johaas-ams/FilaLoom/Media/cable_driven_examples.jpg

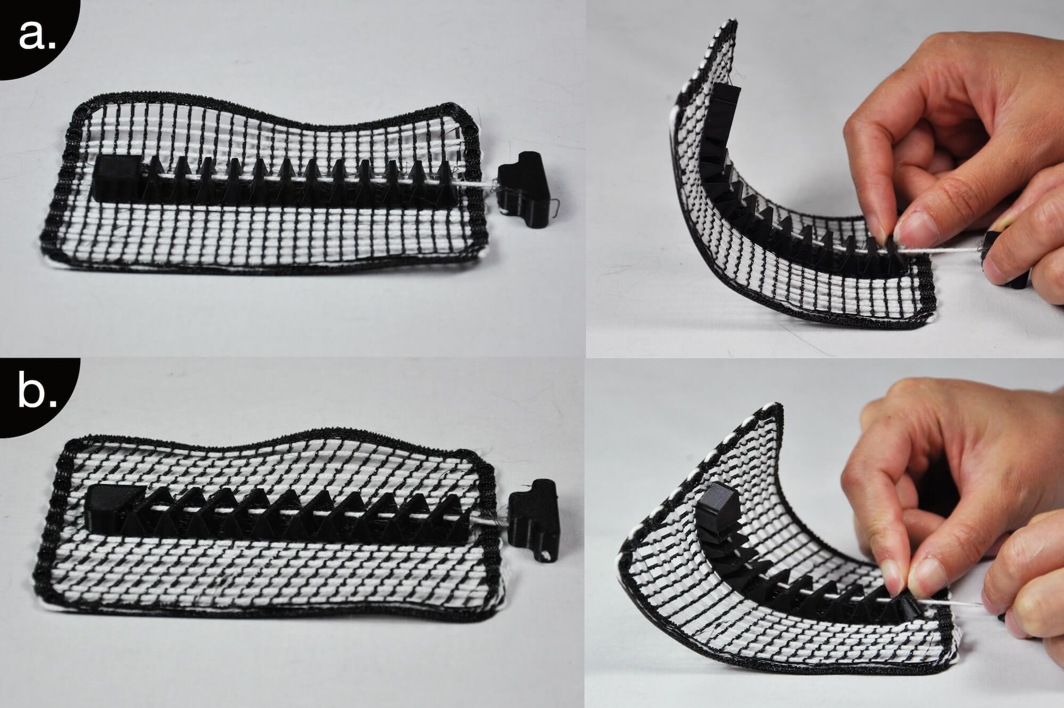
Media/cable_driven_examples.jpg
