johaas-ams/FilaLoom/Media/cable_driven_story_final.jpg

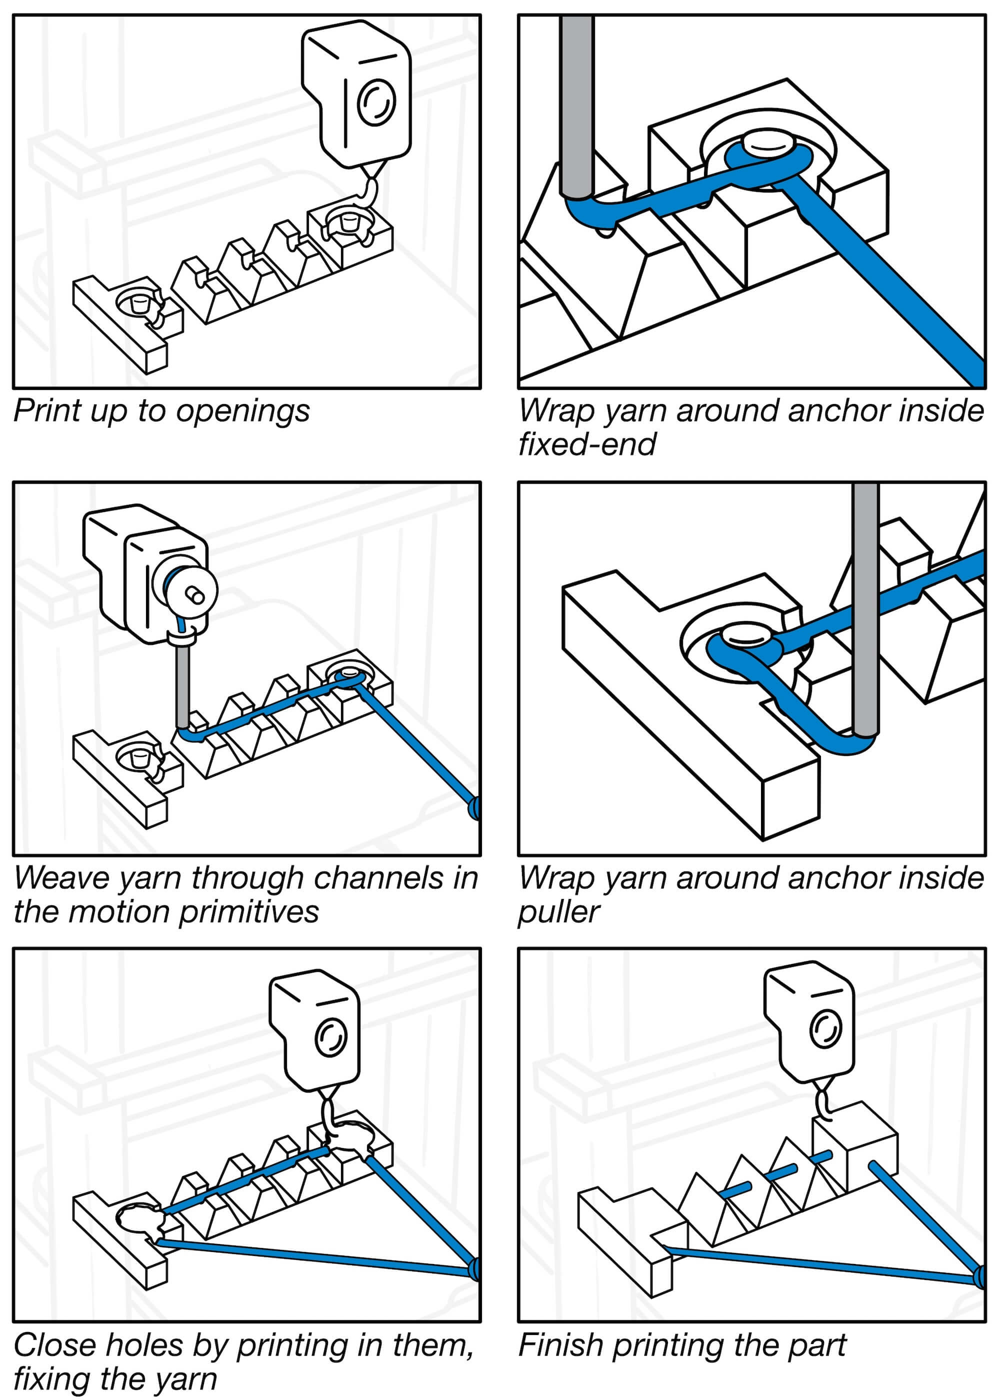
Media/cable_driven_story_final.jpg
