johaas-ams/FilaLoom/Media/cover_final.jpg

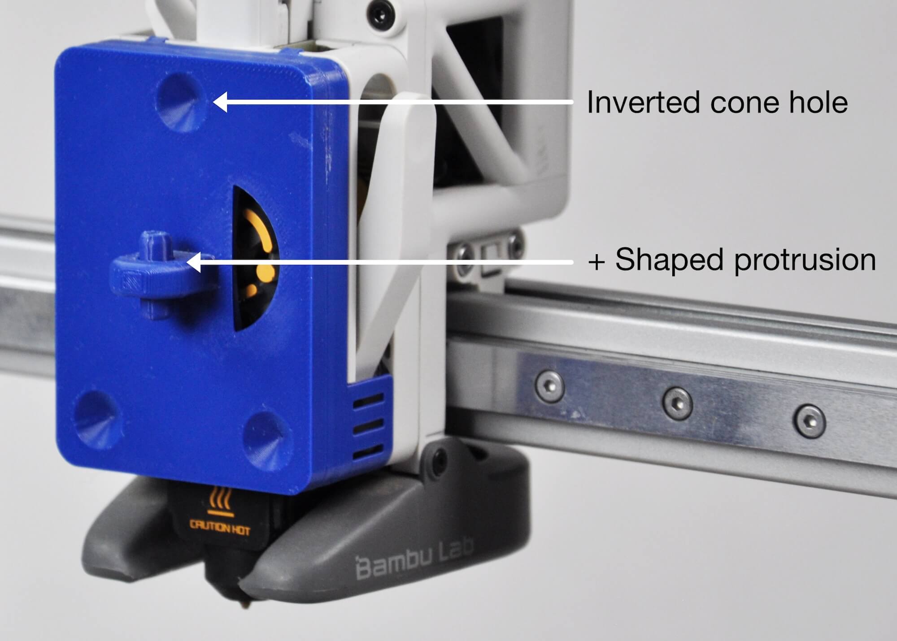
Media/cover_final.jpg
