johaas-ams/FilaLoom/Media/depositor_final.jpg

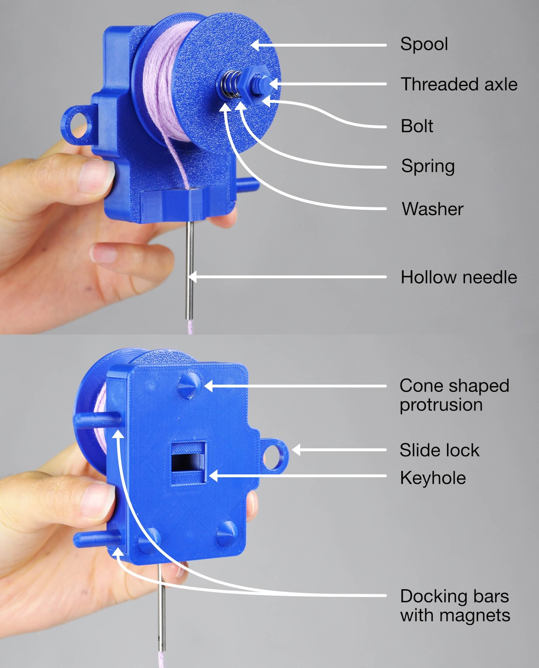
Media/depositor_final.jpg
