johaas-ams/FilaLoom/Media/double_station_final.jpg

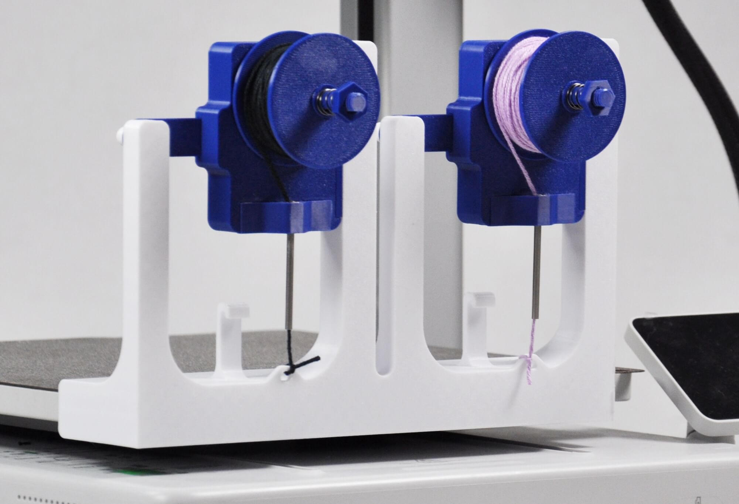
Media/double_station_final.jpg
