johaas-ams/FilaLoom/Media/fixation.jpg

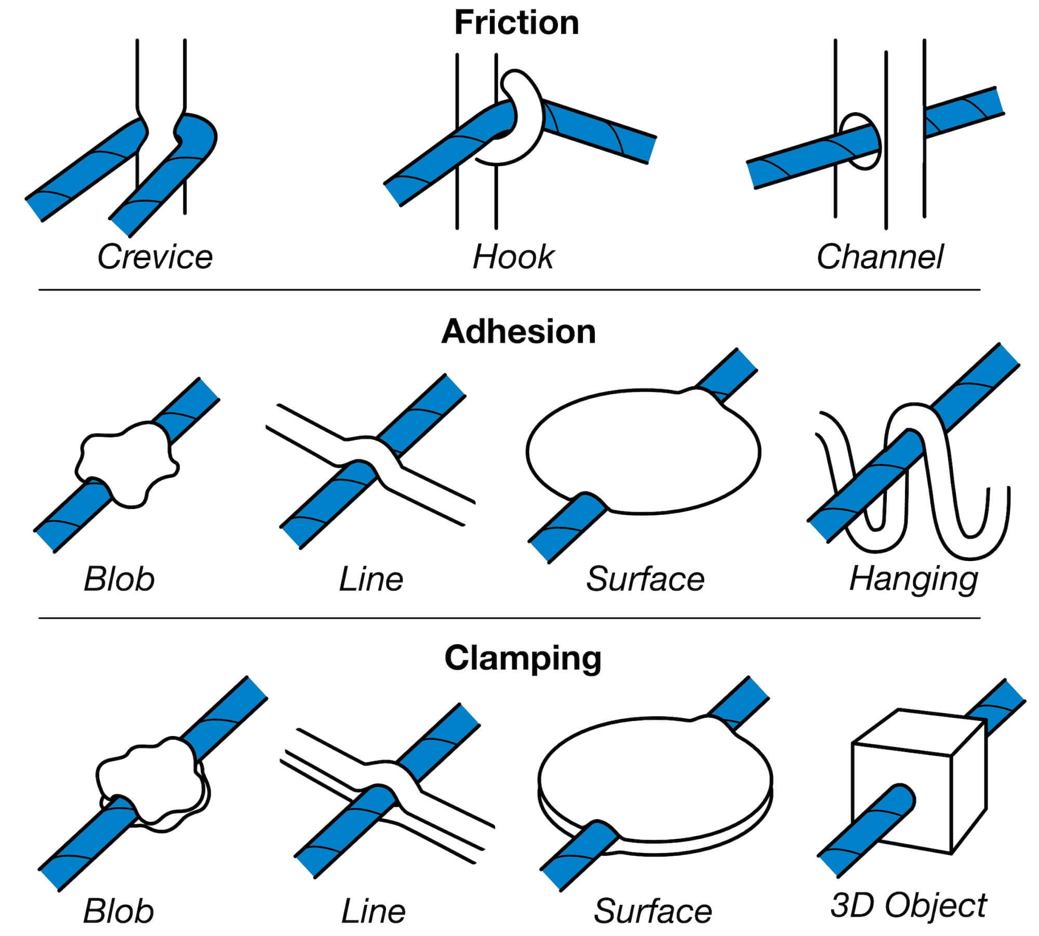
Media/fixation.jpg
