johaas-ams/FilaLoom/Media/general_story_final.jpg

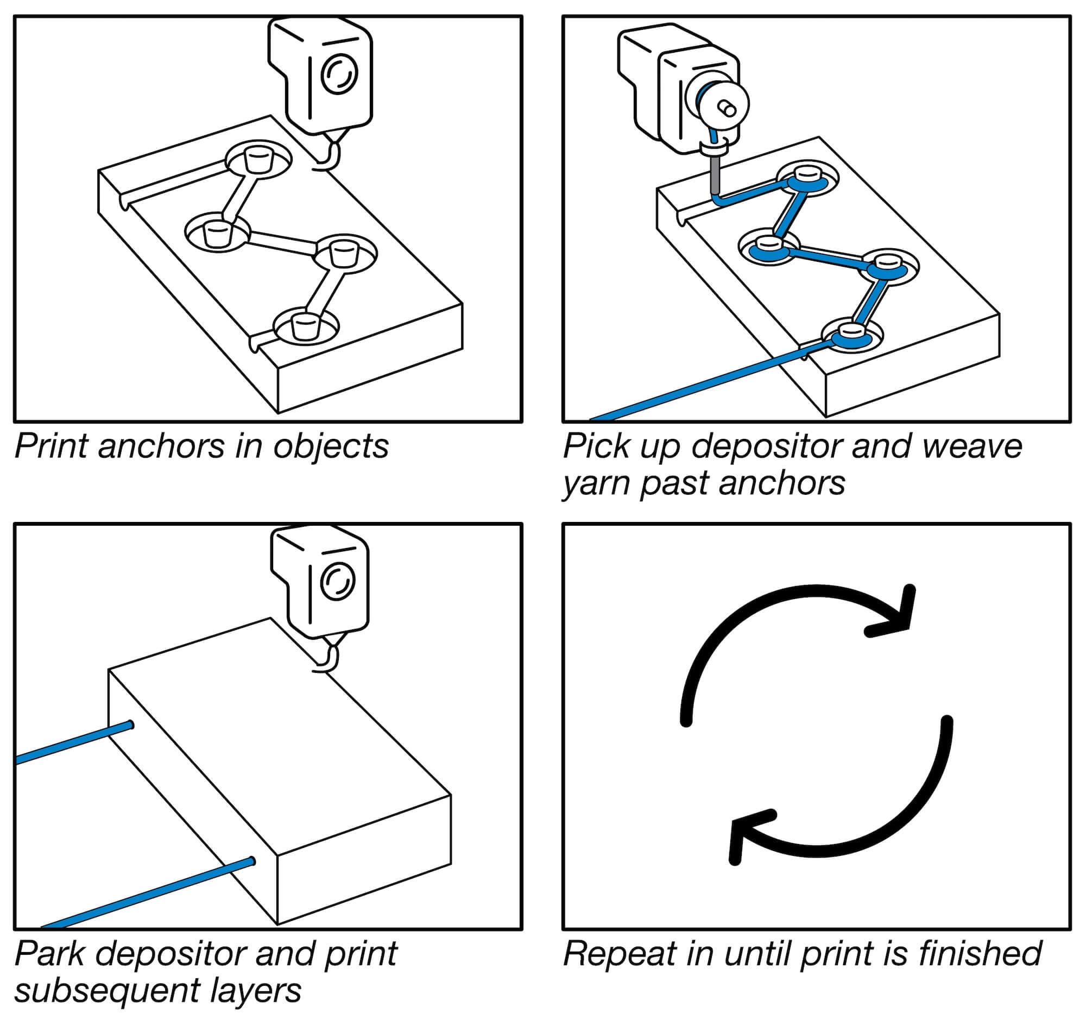
Media/general_story_final.jpg
