johaas-ams/FilaLoom/Media/loops_examples_final.jpg

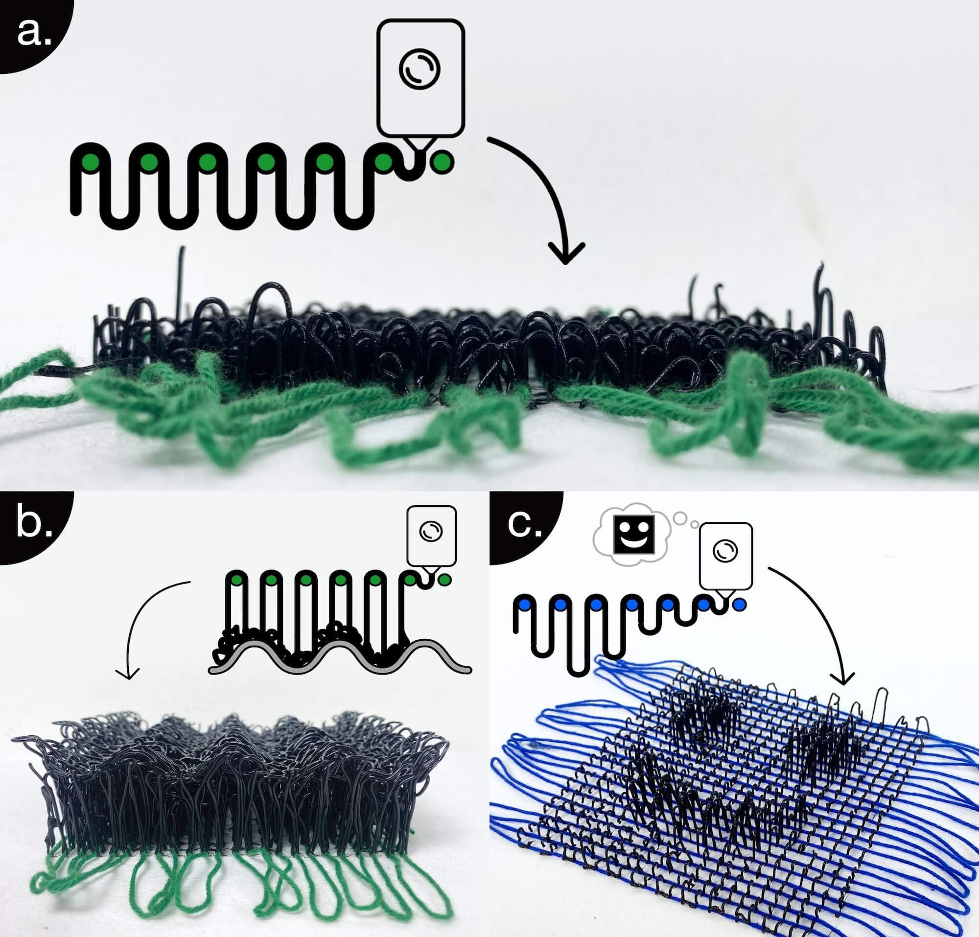
Media/loops_examples_final.jpg
