johaas-ams/FilaLoom/Media/loops_story_final.jpg

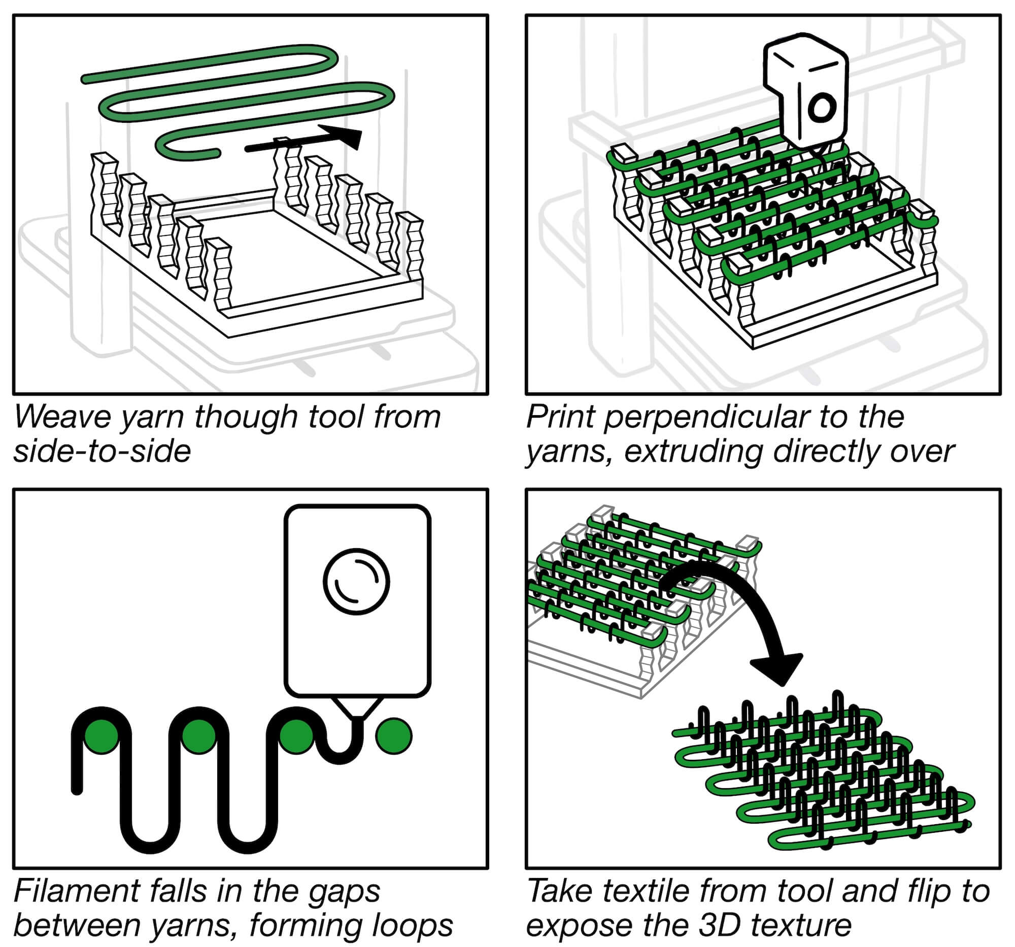
Media/loops_story_final.jpg
