johaas-ams/FilaLoom/Media/pickpark_final.jpg

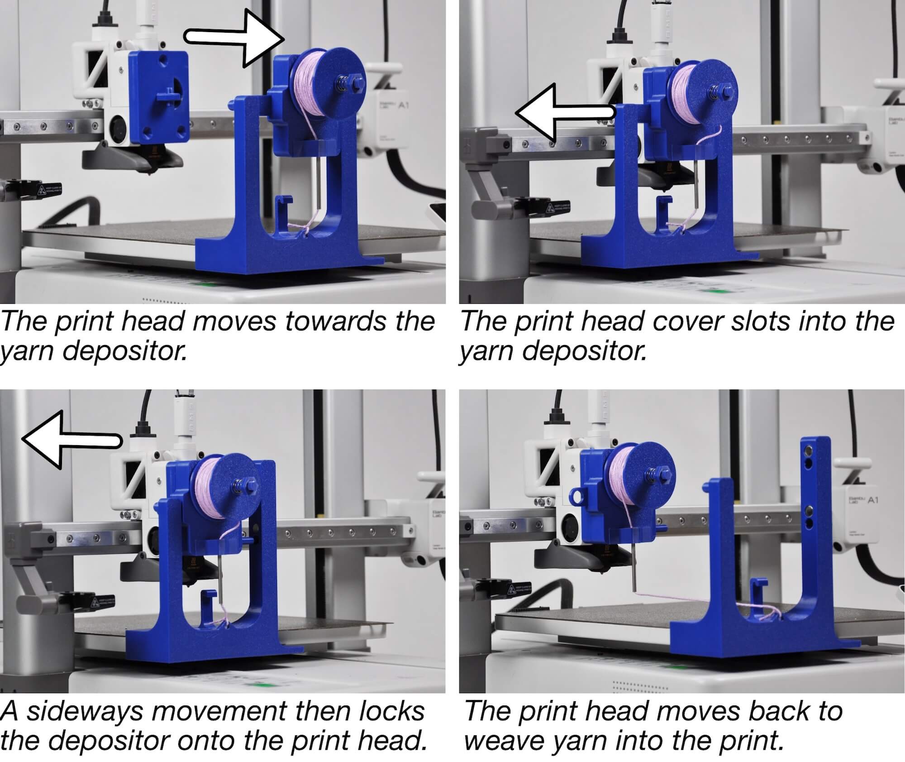
Media/pickpark_final.jpg
