johaas-ams/FilaLoom/Media/pillar_weaving_story_final.jpg

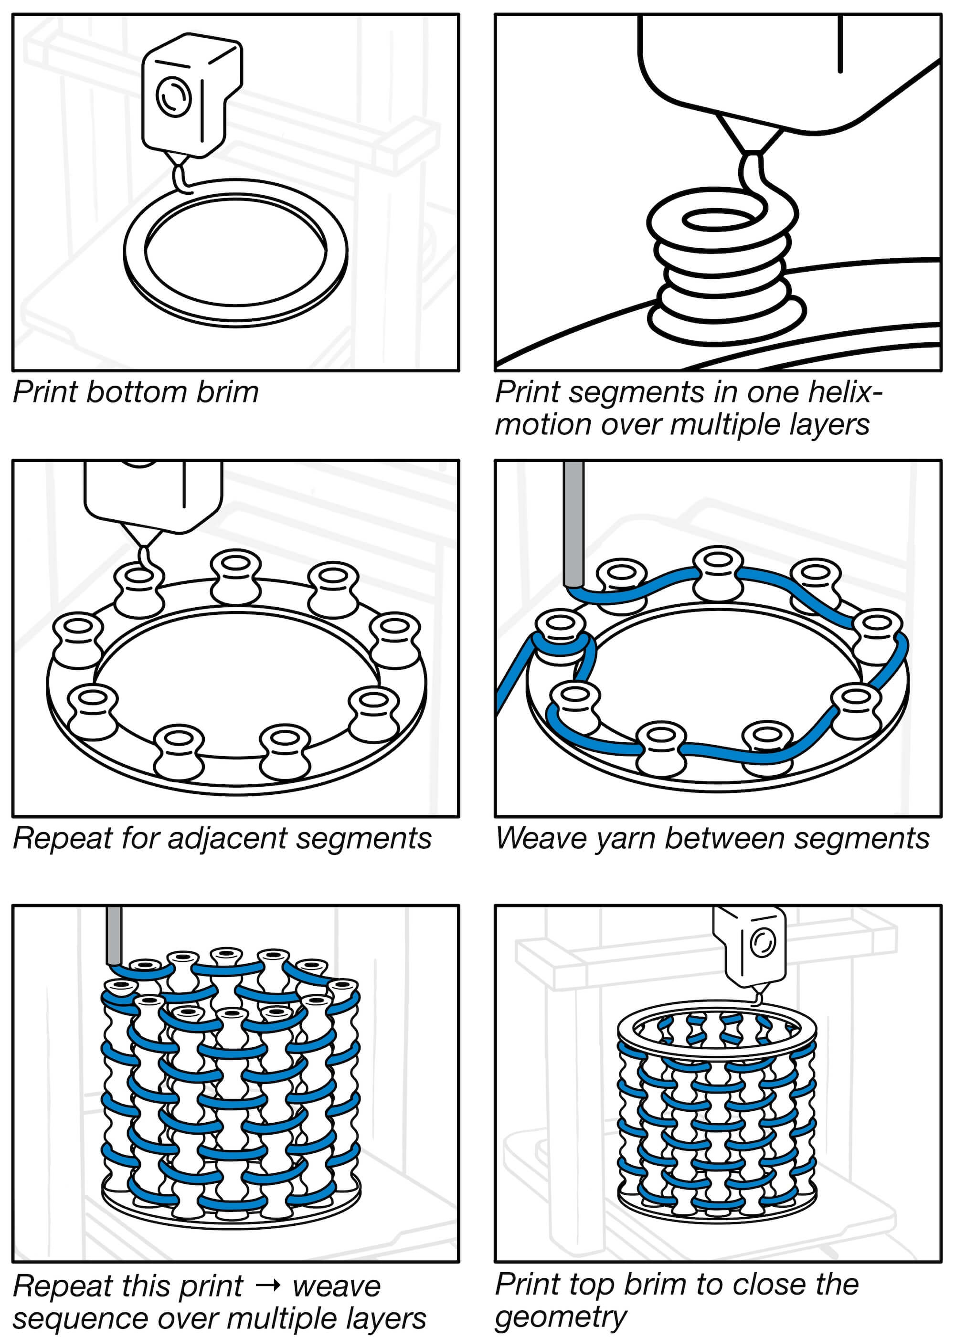
Media/pillar_weaving_story_final.jpg
