johaas-ams/FilaLoom/Media/pillar_weaving_variables.jpg

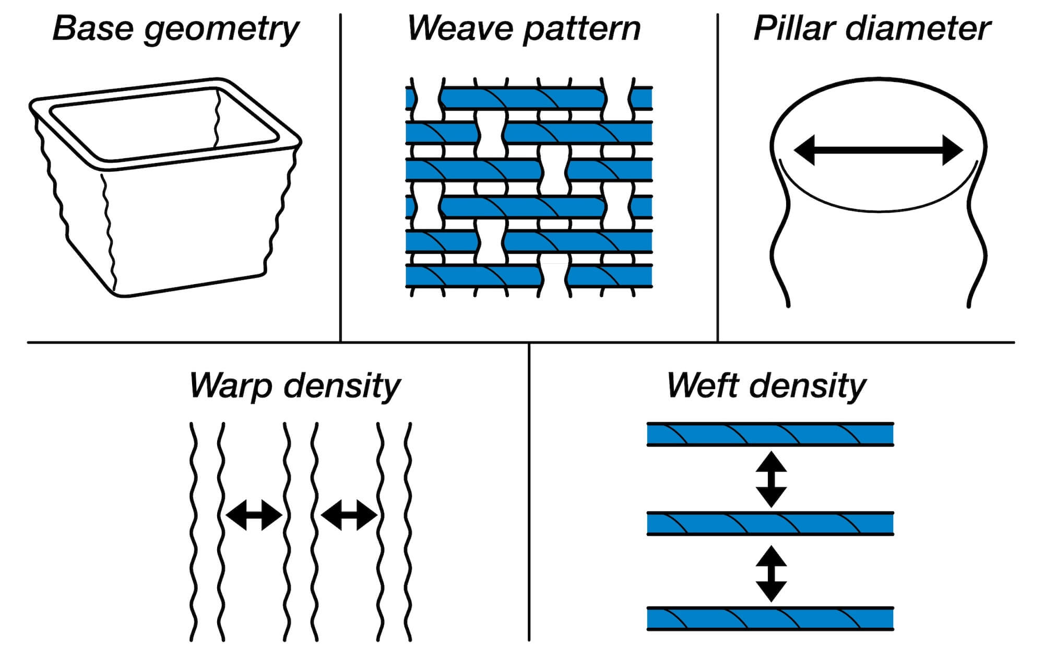
Media/pillar_weaving_variables.jpg
