johaas-ams/FilaLoom/Media/planar_examples.jpg

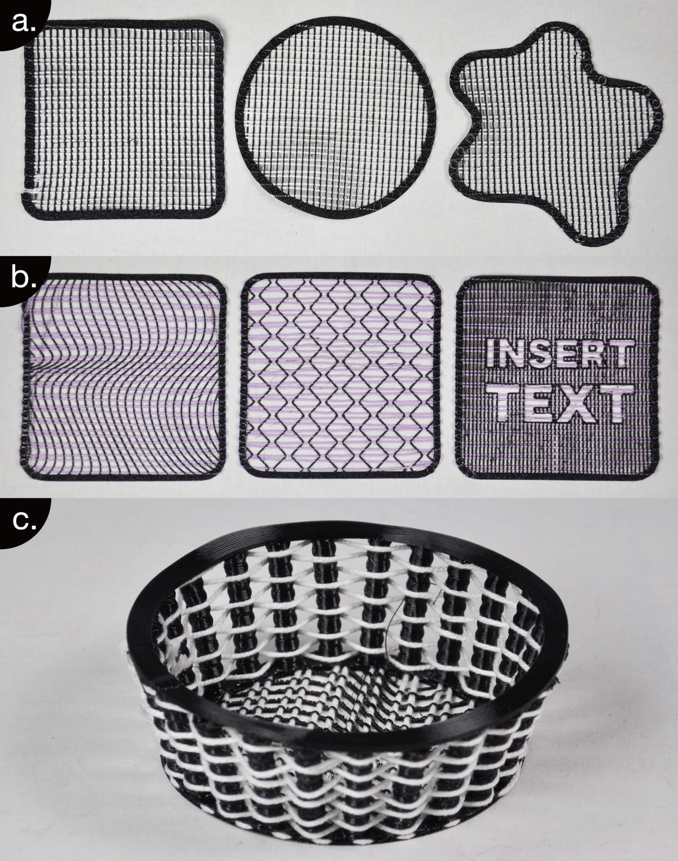
Media/planar_examples.jpg
