johaas-ams/FilaLoom/Media/planar_semi-weaving_story_final.jpg

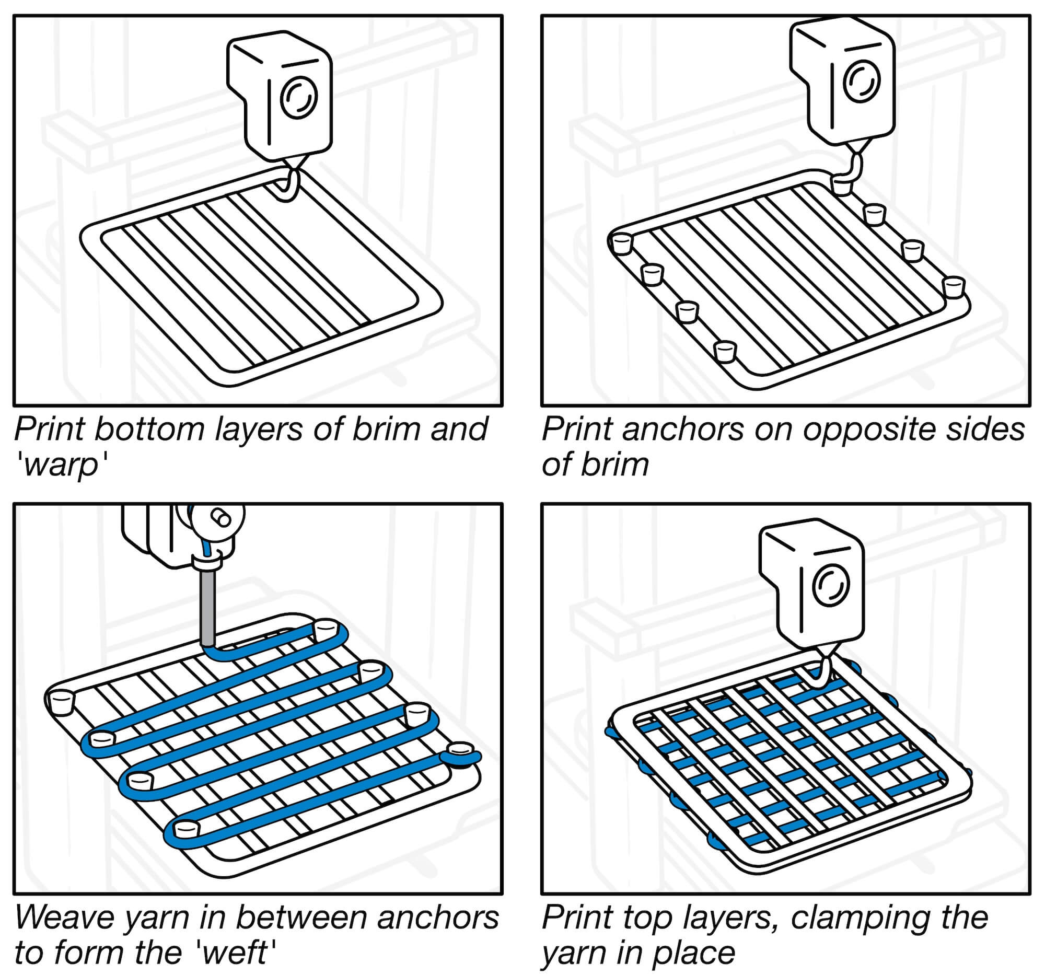
Media/planar_semi-weaving_story_final.jpg
