johaas-ams/FilaLoom/Media/planar_variables.jpg

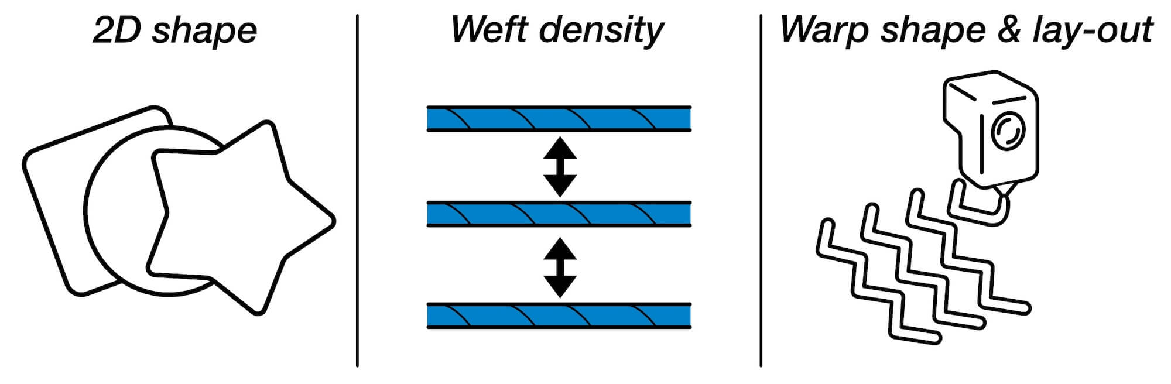
Media/planar_variables.jpg
