johaas-ams/FilaLoom/Media/station_final.jpg

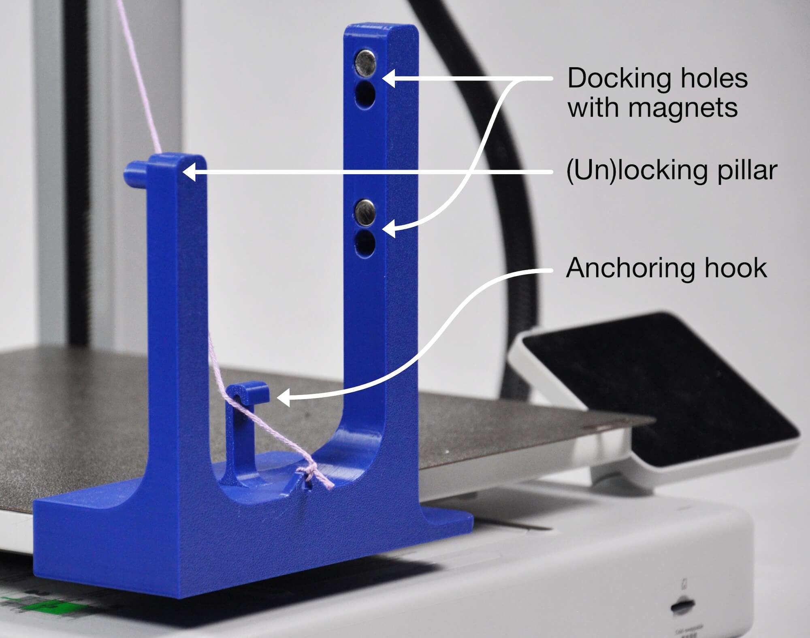
Media/station_final.jpg
