johaas-ams/FilaLoom/Media/textures_examples.jpg

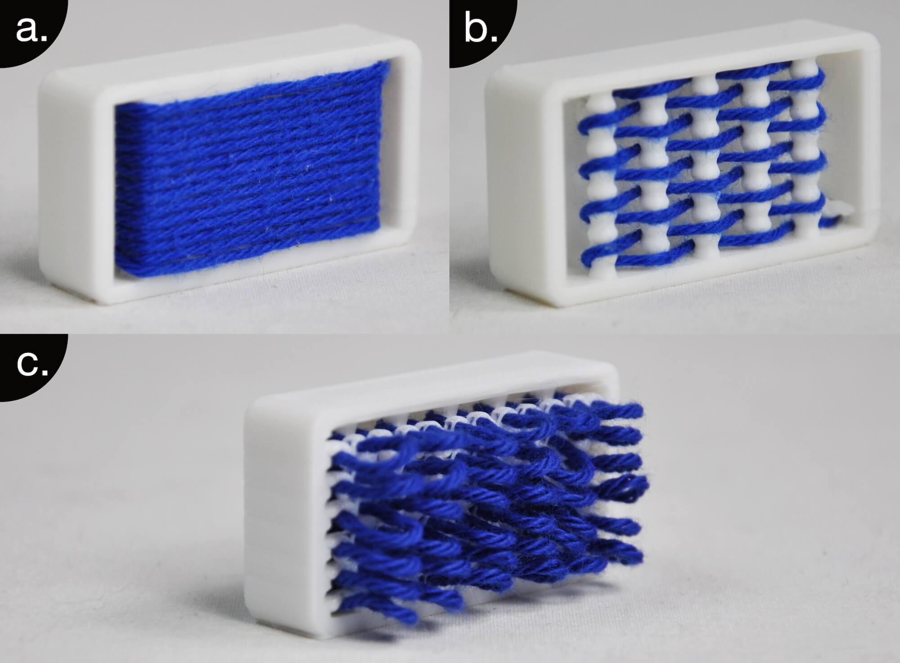
Media/textures_examples.jpg
