johaas-ams/FilaLoom/Media/textures_story_final.jpg

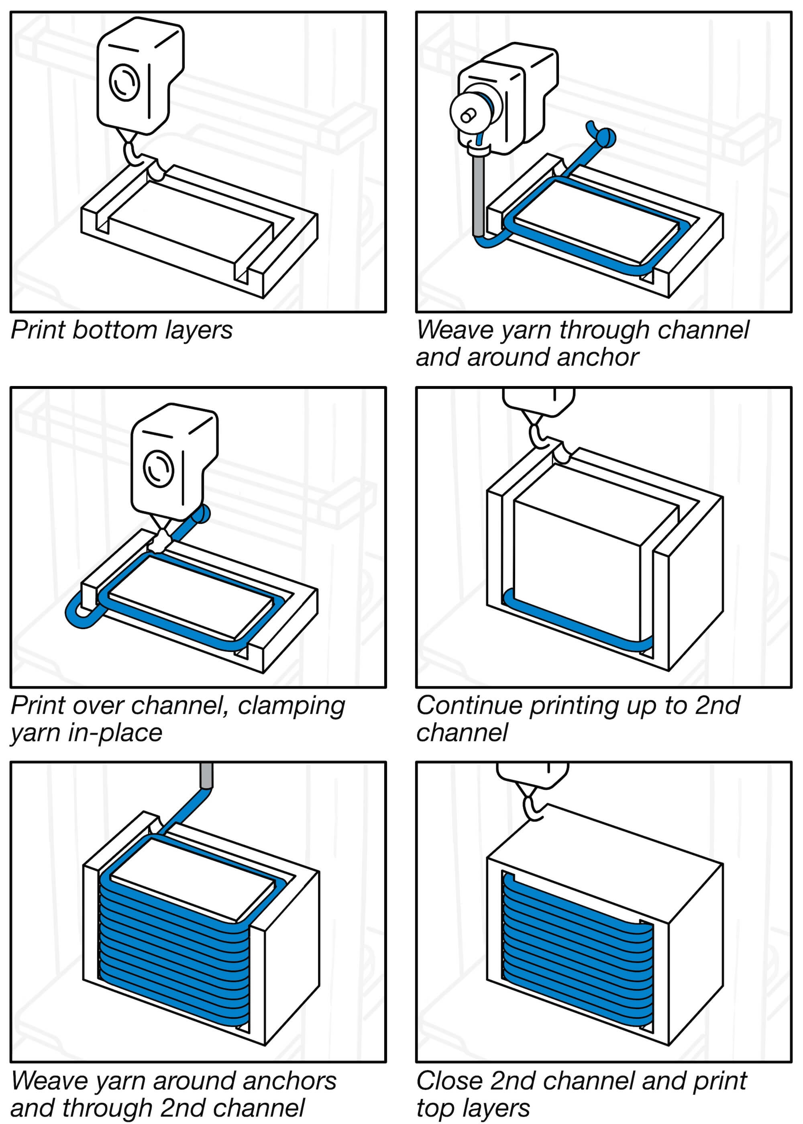
Media/textures_story_final.jpg
