johaas-ams/FilaLoom/Media/textures_variables.jpg

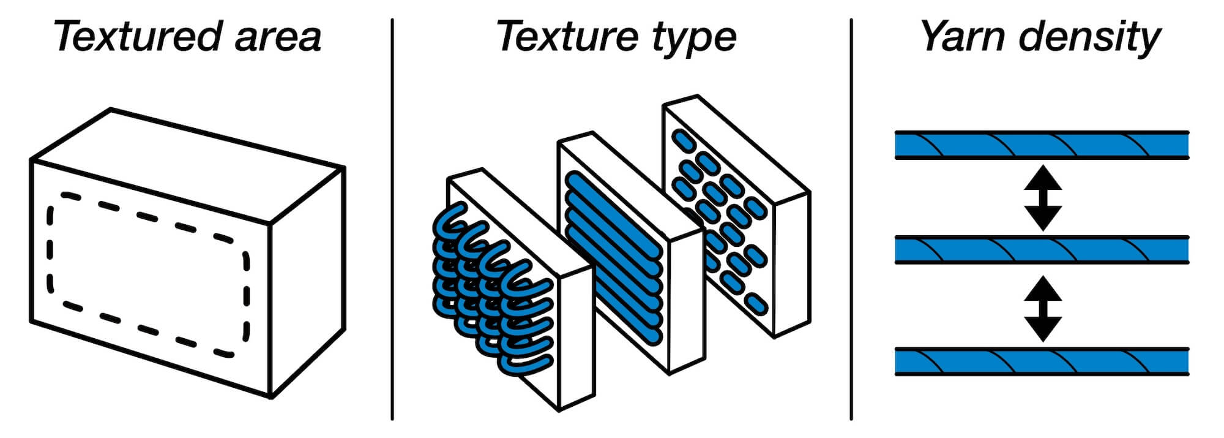
Media/textures_variables.jpg
