johaas-ams/FilaLoom/Media/vertical_examples_final.jpg

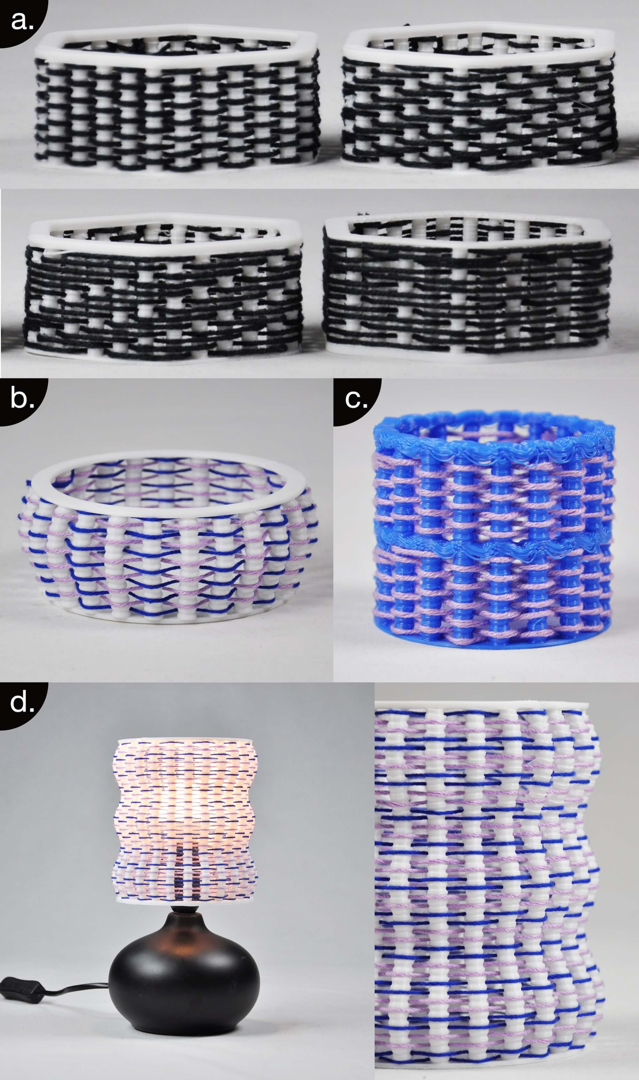
Media/vertical_examples_final.jpg
