johaas-ams/FilaLoom/Media/weaver_tool.jpg

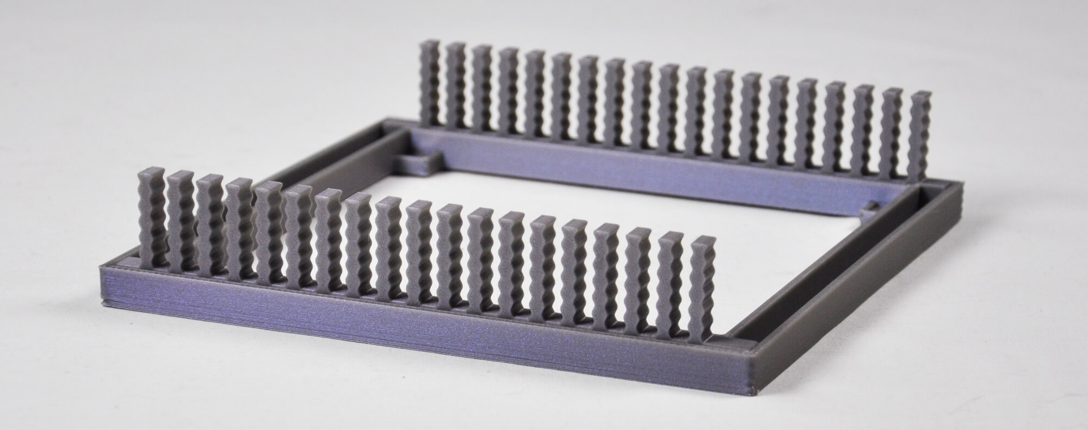
Media/weaver_tool.jpg
