johaas-ams/FilaLoom/Media/material_design_space.jpg

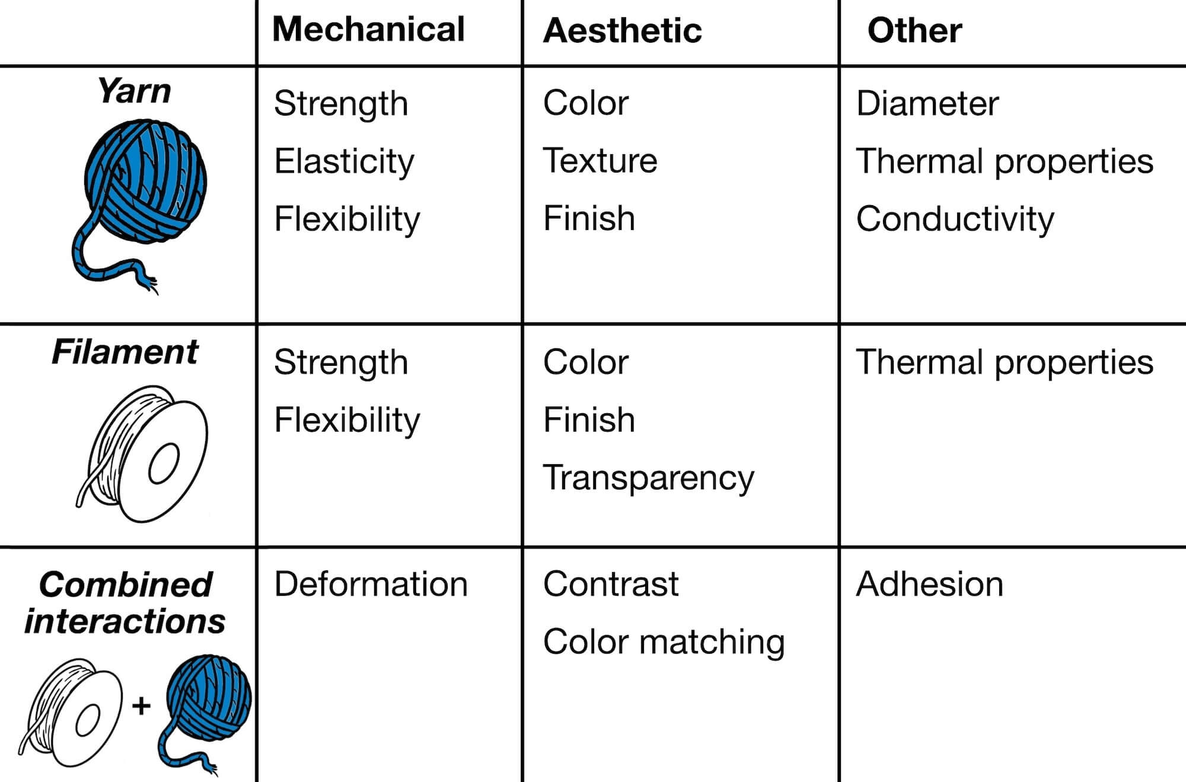
Media/material_design_space.jpg
