johaas-ams/FilaLoom/FilaLoom Components STLs/Print Head Cover/Cover - back.stl

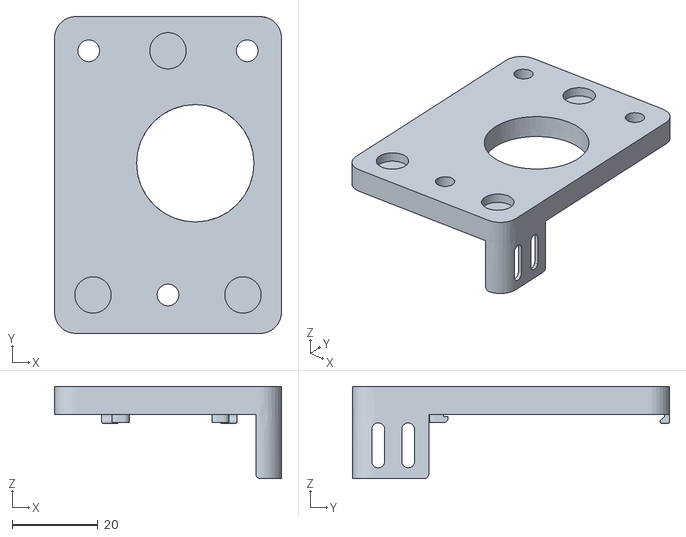
[picture p59: CAD file, 2026-11-12]
FilaLoom Components STLs/Print Head Cover/Cover - back.stl
53.0 x 74.0 x 21.5
