johaas-ams/FilaLoom/FilaLoom Components STLs/Station/Station - Anchor hook.stl

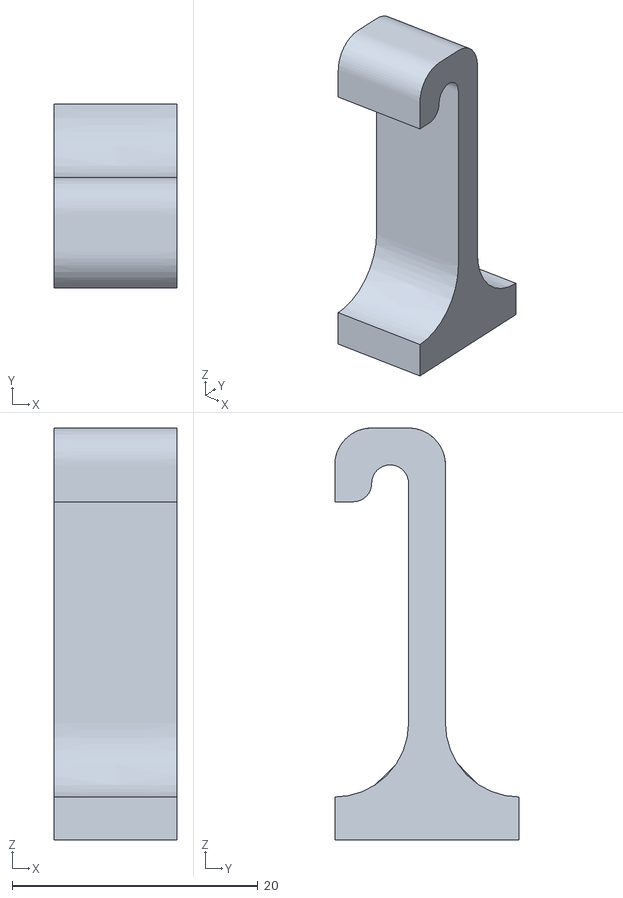
[picture p60: CAD file, 2026-09-30]
FilaLoom Components STLs/Station/Station - Anchor hook.stl
10.0 x 15.0 x 33.5
