johaas-ams/FilaLoom/FilaLoom Components STLs/Yarn Depositor/Depositor - Back Body.stl

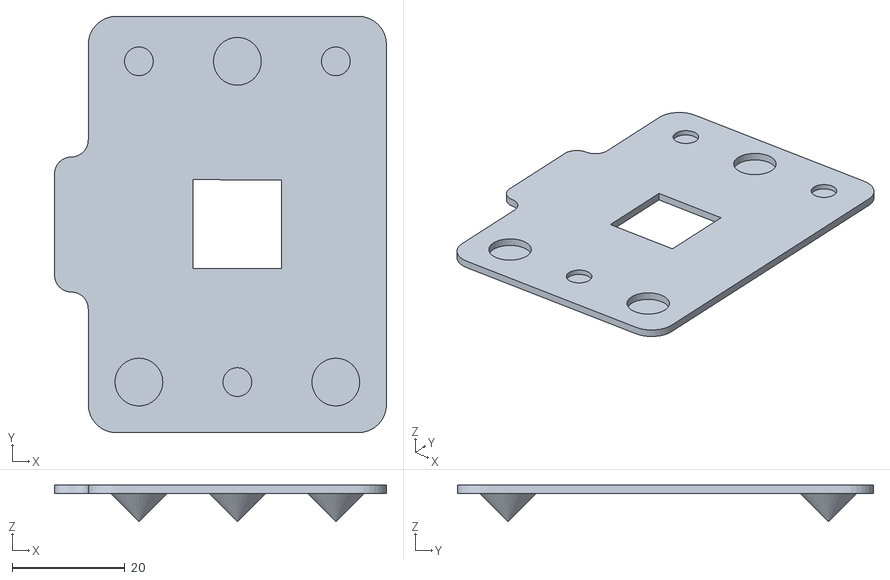
[picture p61: CAD file, 2026-11-12]
FilaLoom Components STLs/Yarn Depositor/Depositor - Back Body.stl
59.0 x 74.0 x 6.50
