johaas-ams/FilaLoom/FilaLoom Components STLs/Print Head Cover/Cover - Lock Cylinder.stl

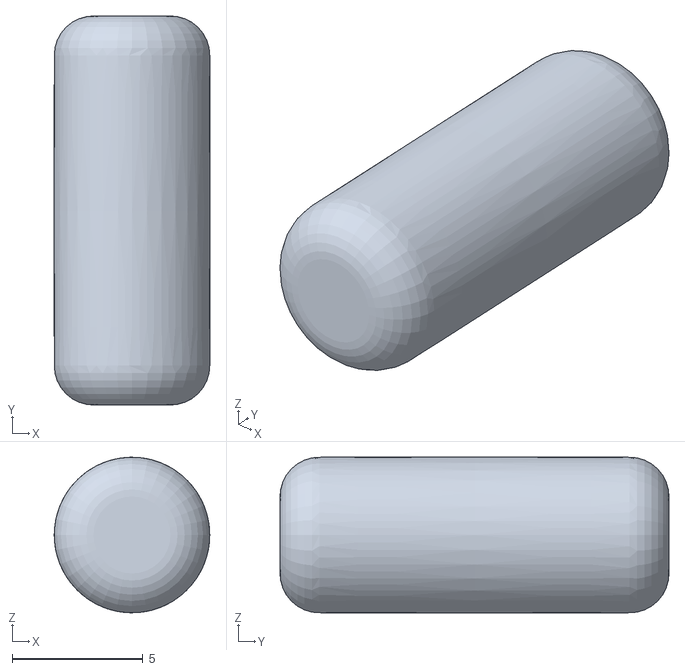
[picture p62: CAD file, 2026-09-30]
FilaLoom Components STLs/Print Head Cover/Cover - Lock Cylinder.stl
5.94 x 14.8 x 5.94
