johaas-ams/FilaLoom/FilaLoom Components STLs/Station/Station.stl

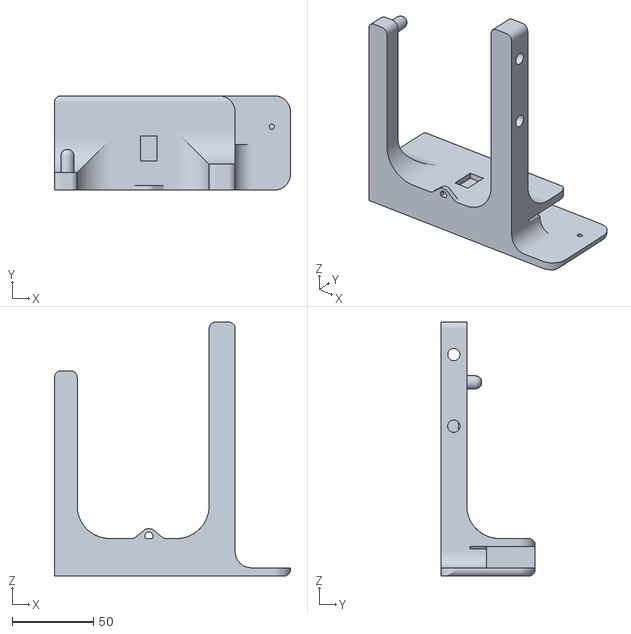
[picture p63: CAD file, 2026-09-30]
FilaLoom Components STLs/Station/Station.stl
145.0 x 58.0 x 156.0
