johaas-ams/FilaLoom/FilaLoom Components STLs/Yarn Depositor/Depositor - Front Body.stl

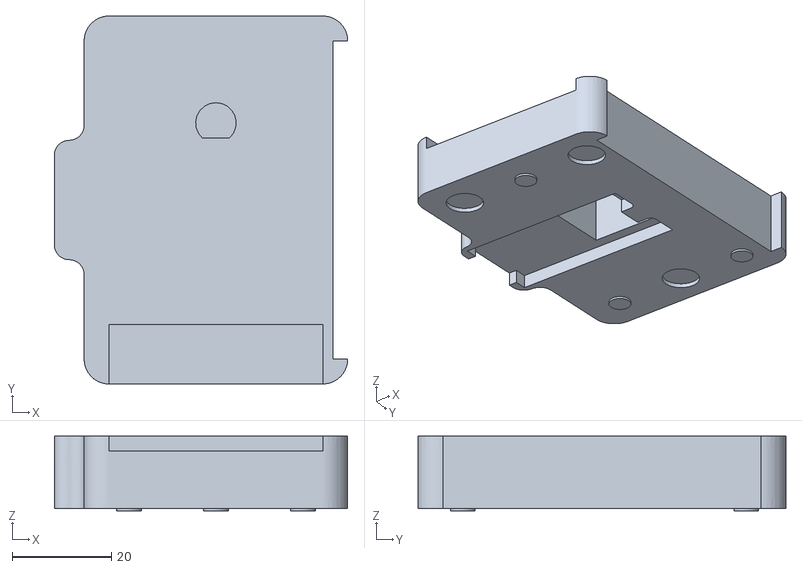
[picture p64: CAD file, 2026-11-12]
FilaLoom Components STLs/Yarn Depositor/Depositor - Front Body.stl
59.0 x 74.0 x 15.0
