johaas-ams/FilaLoom/FilaLoom Components STLs/Print Head Cover/Cover - Positioner (3x).stl

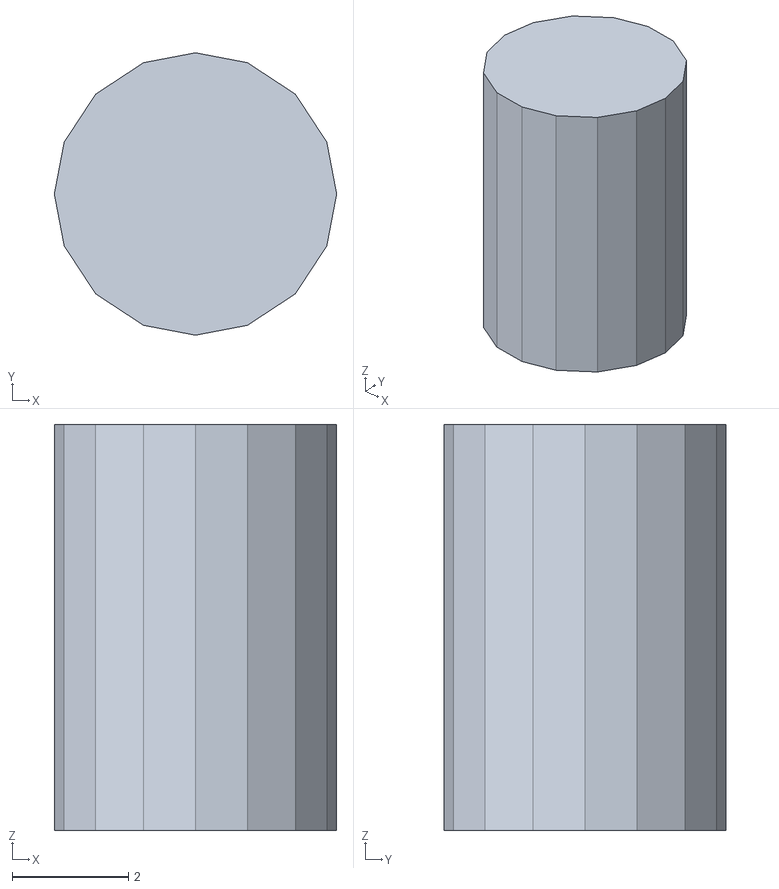
[picture p65: CAD file, 2026-09-30]
FilaLoom Components STLs/Print Head Cover/Cover - Positioner (3x).stl
4.87 x 4.87 x 7.00
