johaas-ams/FilaLoom/FilaLoom Components STLs/Station/Double Station.stl

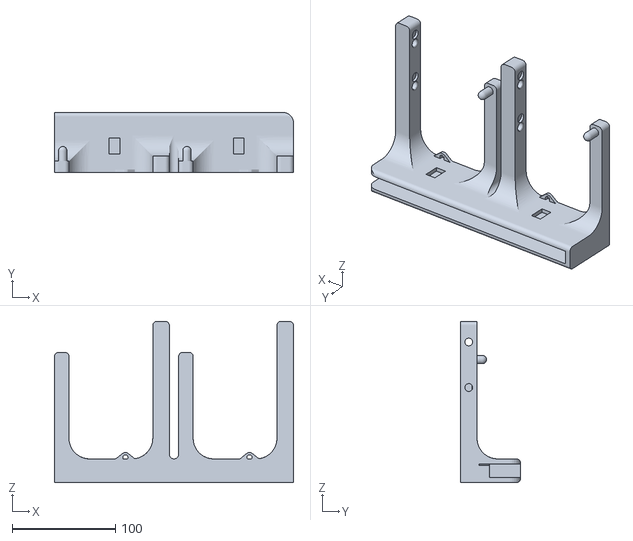
[picture p66: CAD file, 2026-09-30]
FilaLoom Components STLs/Station/Double Station.stl
231.0 x 58.0 x 156.0
