johaas-ams/FilaLoom/FilaLoom Components STLs/Yarn Depositor/Depositor - Slider.stl

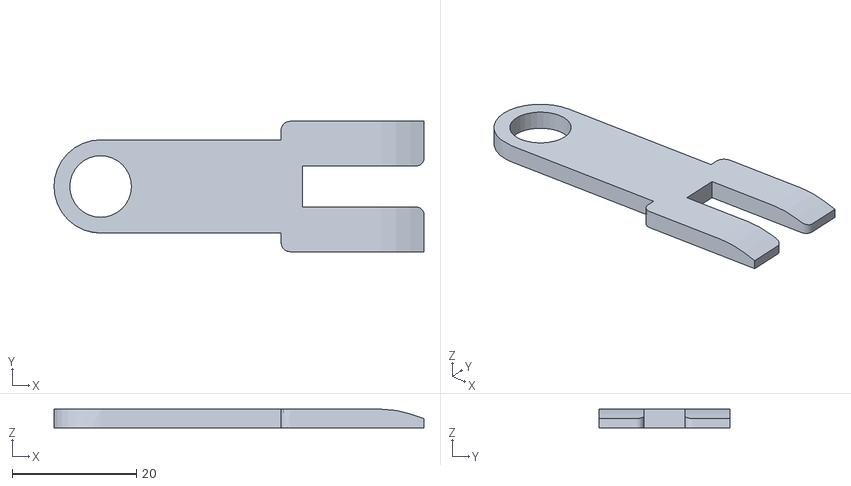
[picture p67: CAD file, 2026-09-30]
FilaLoom Components STLs/Yarn Depositor/Depositor - Slider.stl
59.5 x 21.0 x 3.00
