johaas-ams/FilaLoom/FilaLoom Components STLs/Print Head Cover/Cover - Front.stl

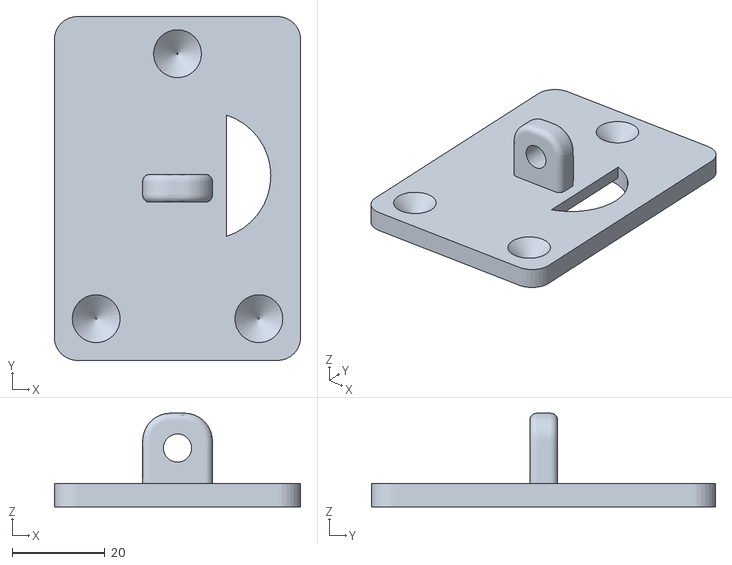
[picture p68: CAD file, 2026-09-30]
FilaLoom Components STLs/Print Head Cover/Cover - Front.stl
53.0 x 74.0 x 20.1
