johaas-ams/FilaLoom/FilaLoom Components STLs/Yarn Depositor/Depositor - Spool.stl

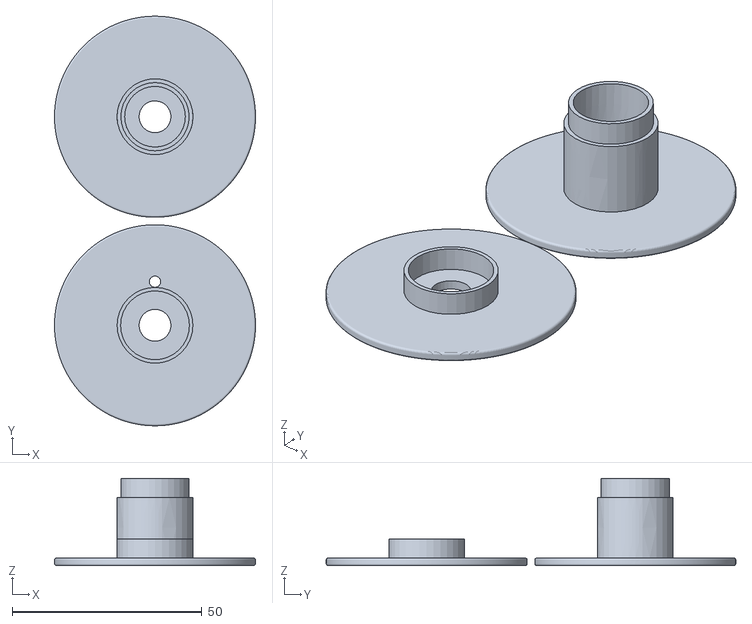
[picture p69: CAD file, 2026-09-30]
FilaLoom Components STLs/Yarn Depositor/Depositor - Spool.stl
53.0 x 108.0 x 23.0
