johaas-ams/FilaLoom/FilaLoom Components STLs/Yarn Depositor/Depositor - Axle.stl

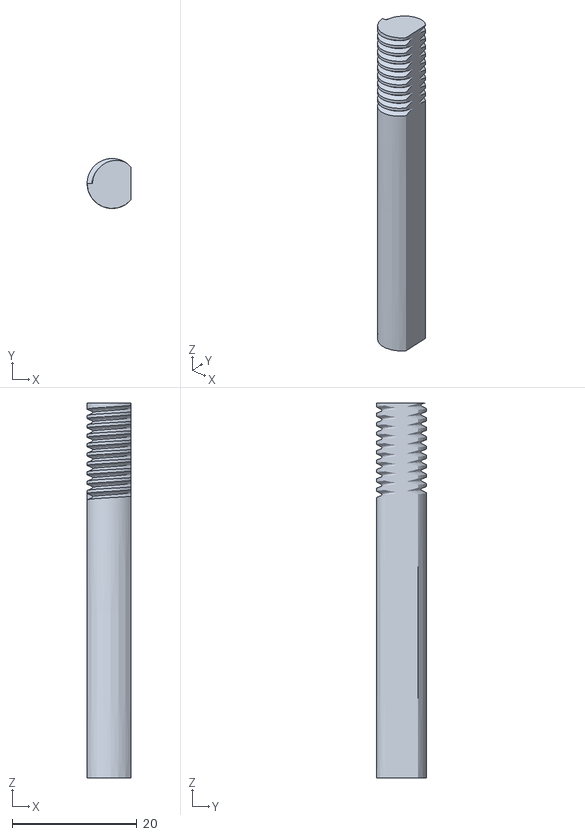
[picture p70: CAD file, 2026-09-30]
FilaLoom Components STLs/Yarn Depositor/Depositor - Axle.stl
7.00 x 8.00 x 60.0
