johaas-ams/FilaLoom/FilaLoom Components STLs/Yarn Depositor/Depositor - Docking Bars.stl

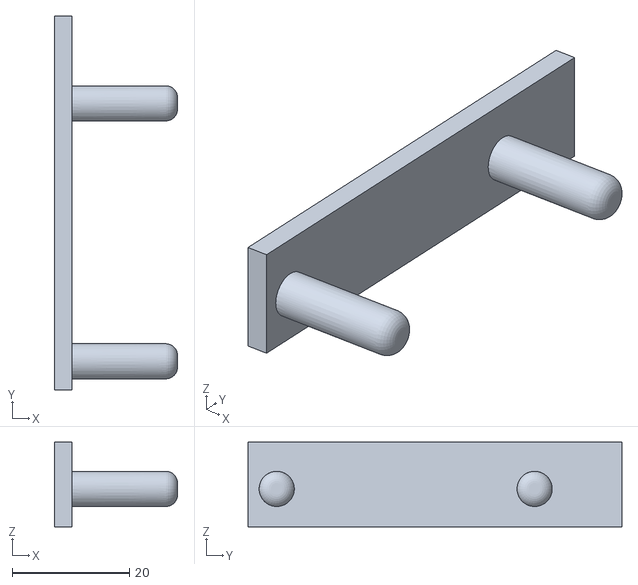
[picture p71: CAD file, 2026-09-30]
FilaLoom Components STLs/Yarn Depositor/Depositor - Docking Bars.stl
21.0 x 63.8 x 14.5
