johaas-ams/FilaLoom/FilaLoom Components STLs/Yarn Depositor/Depositor - Needle Holder.stl

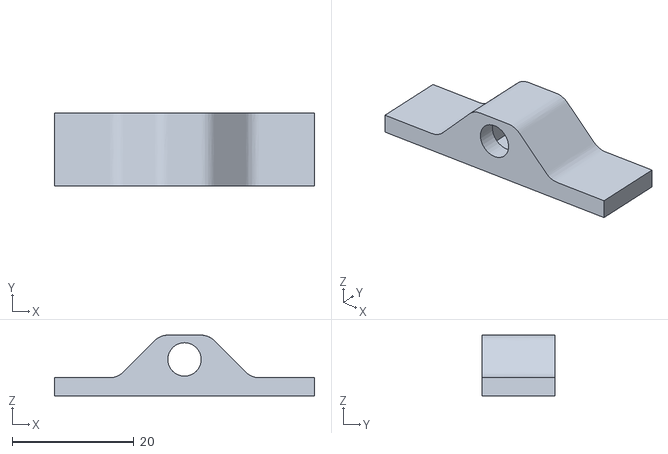
[picture p72: CAD file, 2026-09-30]
FilaLoom Components STLs/Yarn Depositor/Depositor - Needle Holder.stl
42.8 x 12.0 x 10.0
