johaas-ams/FilaLoom/FilaLoom Components STLs/Yarn Depositor/Depositor - Washer.stl

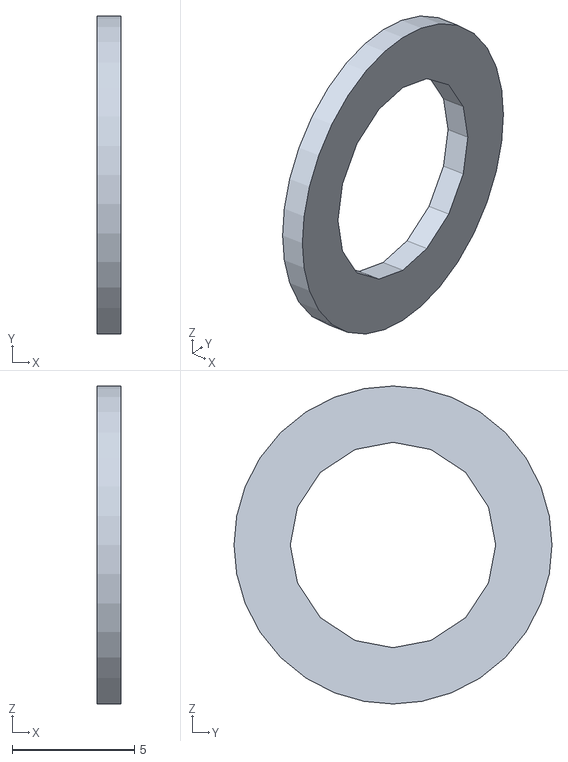
[picture p73: CAD file, 2026-09-30]
FilaLoom Components STLs/Yarn Depositor/Depositor - Washer.stl
1.00 x 13.0 x 13.0
