johaas-ams/FilaLoom/FilaLoom Components STLs/Yarn Depositor/Depositor - Bolt.stl

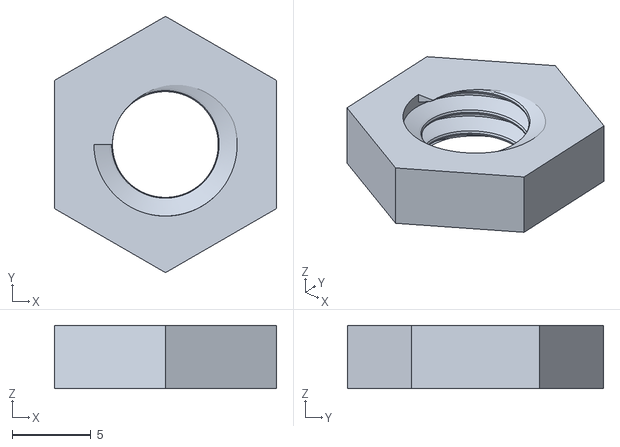
[picture p74: CAD file, 2026-09-30]
FilaLoom Components STLs/Yarn Depositor/Depositor - Bolt.stl
14.1 x 16.2 x 4.00
