johaas-ams/FilaLoom/(commit log)

2026-09-30 Add Filaloom Components STLs
    [Cover - Front.stl, Cover - Lock Cylinder.stl, Cover - Positioner (3x).stl, Cover - back.stl, Depositor - Axle.stl, Depositor - Back.stl, Depositor - Body.stl, Depositor - Bolt.stl]
2026-09-30 Rename Cable Driven Mechanisms.gh to Grasshopper Scripts/Cable Driven Mechanisms.gh
2026-09-30 Rename Loop-based Spacer Fabrics.gh to Grasshopper Scripts/Loop-based Spacer Fabrics.gh
2026-09-30 Rename Depositor - Body.stl to Depositor - Front Body.stl
    [Depositor - Front Body.stl]
2026-09-30 Rename Depositor - Back.stl to Depositor - Back Body.stl
    [Depositor - Back Body.stl]
2026-10-02 Add Assembly Instructions
2026-11-12 Update Cover - back.stl
2026-11-12 Update Depositor - Front Body.stl
2026-11-12 Update Depositor - Back Body.stl
